quangvd917/ab125-kline/hardware/kline-l9637d/bom.csv

Ref | Value | Footprint | Qty
C1 | 100uF 35V | Capacitor_THT:CP_Radial_D6.3mm_P2.50mm | 1
C2,C4,C5 | 100nF | Capacitor_SMD:C_1206_3216Metric_Pad1.33x1.80mm_HandSolder | 3
C3 | 470uF 16V | Capacitor_SMD:CP_Elec_8x10 | 1
D1 | SS34 | Diode_SMD:D_SMA | 1
D2 | 1N4148W | Diode_SMD:D_SOD-123 | 1
D3 | SMBJ24A | Diode_SMD:D_SMB | 1
D4 | SMBJ18A | Diode_SMD:D_SMB | 1
H1-H4 | M3 | MountingHole:MountingHole_3.2mm_M3 | 4
J1 | DLC (+12V, K, GND) | Connector_JST:JST_XH_S3B-XH-A_1x03_P2.50mm_Horizontal | 1
J2 | ESP32 (5V, GND, TX, 3V3, RX) | Connector_JST:JST_XH_S5B-XH-A_1x05_P2.50mm_Horizontal | 1
J3 | MP1584 IN+ | Connector_PinHeader_2.54mm:PinHeader_1x02_P2.54mm_Vertical | 1
J4 | MP1584 OUT+ | Connector_PinHeader_2.54mm:PinHeader_1x02_P2.54mm_Vertical | 1
J5 | MP1584 IN- | Connector_PinHeader_2.54mm:PinHeader_1x02_P2.54mm_Vertical | 1
J6 | MP1584 OUT- | Connector_PinHeader_2.54mm:PinHeader_1x02_P2.54mm_Vertical | 1
JP1 | LI -> VS (bridge 2-3) | Jumper:SolderJumper-3_P1.3mm_Open_RoundedPad1.0x1.5mm | 1
L1 | 22uH 1A | Inductor_SMD:L_Changjiang_FXL0630 | 1
R1 | 1k 1/4W | Resistor_SMD:R_1206_3216Metric_Pad1.30x1.75mm_HandSolder | 1
U1 | L9637D | Package_SO:SOIC-8_3.9x4.9mm_P1.27mm | 1
