quangvd917/ab125-kline/hardware/kline-l9637d/kline_l9637d_schematic.pdf

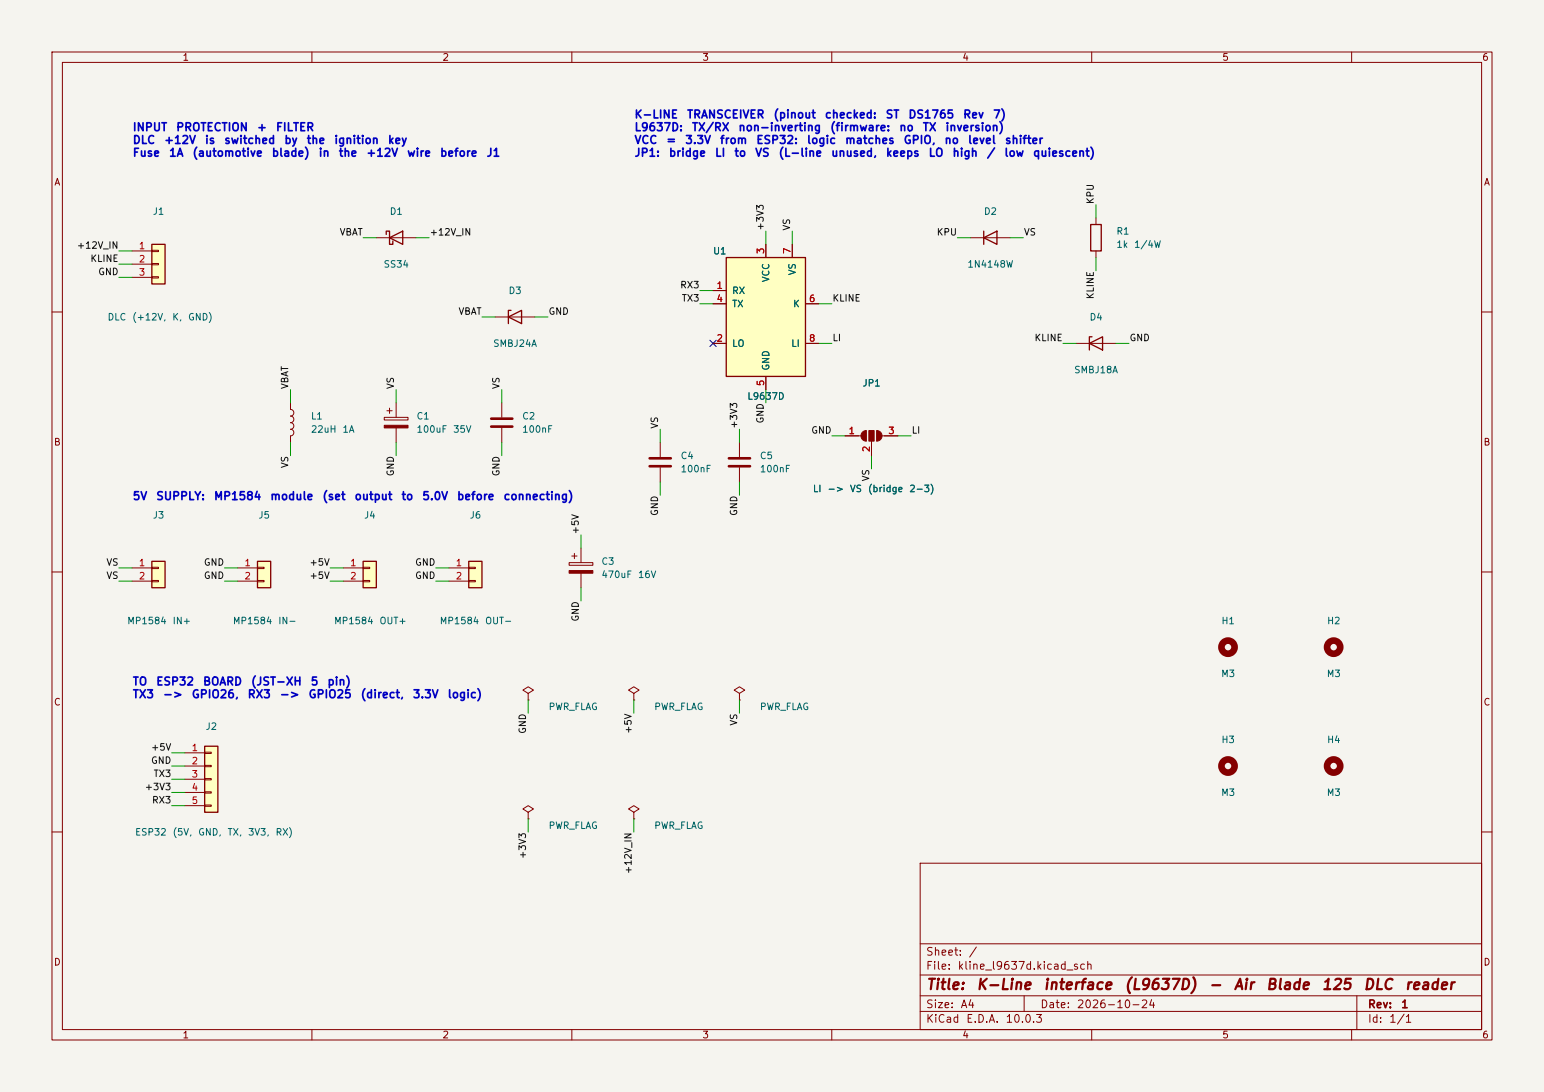
[picture p8: page 1]

INPUT PROTECTION + FILTER
DLC +12V is switched by the ignition key
Fuse 1A (automotive blade) in the +12V wire before J1

L9637D: TX/RX non-inverting (firmware: no TX inversion)
VCC = 3.3V from ESP32: logic matches GPIO, no level shifter
JP1: bridge LI to VS (L-line unused, keeps LO high / low quiescent)

5V SUPPLY: MP1584 module (set output to 5.0V before connecting)

TO ESP32 BOARD (JST-XH 5 pin)
TX3 -> GPIO26, RX3 -> GPIO25 (direct, 3.3V logic)

Sheet: /
File: kline_l9637d.kicad_sch
Title: K-Line interface (L9637D) - Air Blade 125 DLC reader

Size: A4 | Rev: 1
KiCad E.D.A. 10.0.3 | Id: 1/1
