quangvd917/ab125-kline/hardware/kline-l9637d/kline_l9637d.kicad_pcb

## KiCad design hardware/kline-l9637d/kline_l9637d.kicad_pcb (2026-10-25)

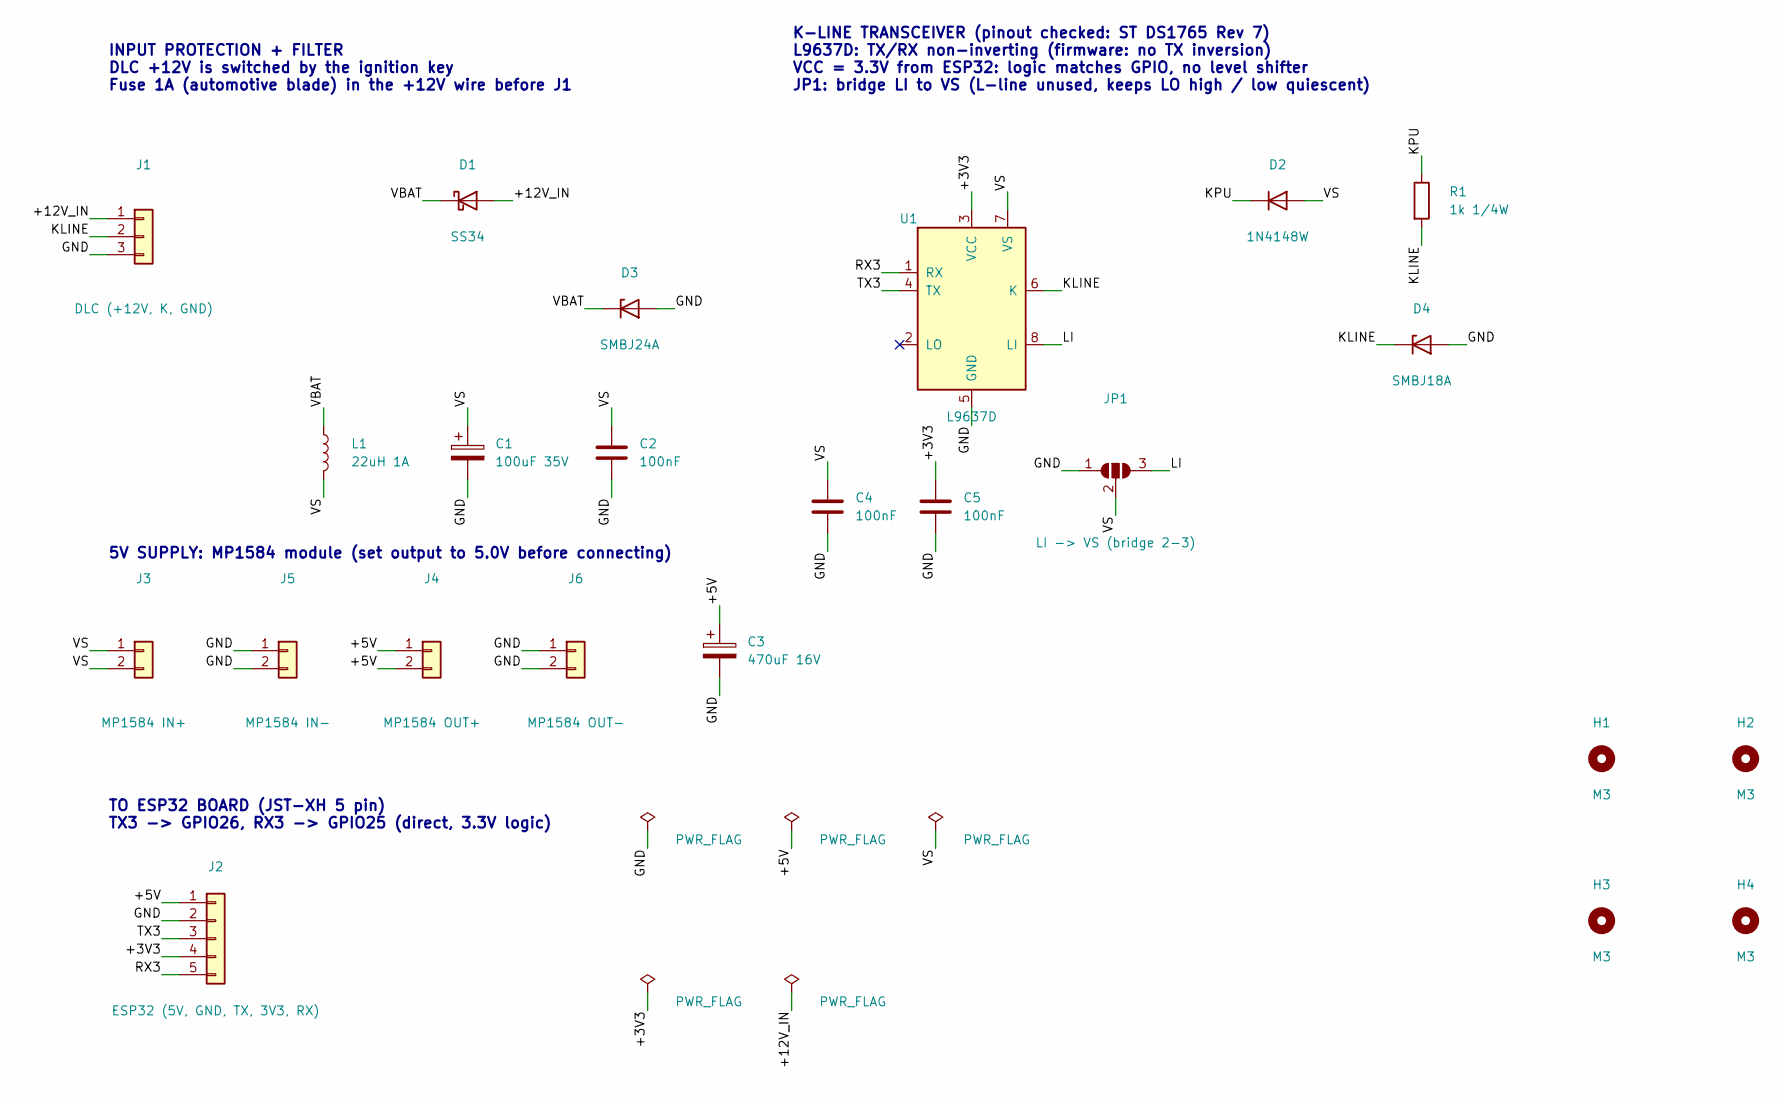
[picture p9: schematic kline_l9637d.kicad_sch, K-Line interface (L9637D) - Air Blade 125 DLC reader]

Parts:
C1: 100uF 35V; CP_Radial_D6.3mm_P2.50mm
C2, C4, C5: 100nF; C_1206_3216Metric_Pad1.33x1.80mm_HandSolder
C3: 470uF 16V; CP_Elec_8x10
D1: SS34; D_SMA
D2: 1N4148W; D_SOD-123
D3: SMBJ24A; D_SMB
D4: SMBJ18A; D_SMB
H1, H2, H3, H4: M3; MountingHole_3.2mm_M3
J1: DLC (+12V, K, GND); JST_XH_S3B-XH-A_1x03_P2.50mm_Horizontal
J2: ESP32 (5V, GND, TX, 3V3, RX); JST_XH_S5B-XH-A_1x05_P2.50mm_Horizontal
J3: MP1584 IN+; PinHeader_1x02_P2.54mm_Vertical
J4: MP1584 OUT+; PinHeader_1x02_P2.54mm_Vertical
J5: MP1584 IN-; PinHeader_1x02_P2.54mm_Vertical
J6: MP1584 OUT-; PinHeader_1x02_P2.54mm_Vertical
JP1: LI -> VS (bridge 2-3); SolderJumper-3_P1.3mm_Open_RoundedPad1.0x1.5mm
L1: 22uH 1A; L_Changjiang_FXL0630
R1: 1k 1/4W; R_1206_3216Metric_Pad1.30x1.75mm_HandSolder
U1: L9637D; SOIC-8_3.9x4.9mm_P1.27mm

Connections:
/+3V3: C5.1, J2.4, U1.3 (VCC)
/+5V: C3.1, J2.1, J4.1, J4.2
/+12V_IN: D1.2 (A), J1.1
/GND: C1.2, C2.2, C3.2, C4.2, C5.2, D3.2 (A), D4.2 (A), J1.3, J2.2, J5.1, J5.2, J6.1, J6.2, JP1.1 (A), U1.5 (GND)
/KLINE: D4.1 (K), J1.2, R1.2, U1.6 (K)
/KPU: D2.1 (K), R1.1
/LI: JP1.3 (B), U1.8 (LI)
/RX3: J2.5, U1.1 (RX)
/TX3: J2.3, U1.4 (TX)
/VBAT: D1.1 (K), D3.1 (K), L1.1
/VS: C1.1, C2.1, C4.1, D2.2 (A), J3.1, J3.2, JP1.2 (C), L1.2, U1.7 (VS)

Notes on the sheet:
K-LINE TRANSCEIVER (pinout checked: ST DS1765 Rev 7) L9637D: TX/RX non-inverting (firmware: no TX inversion) VCC = 3.3V from ESP32: logic matches GPIO, no level shifter JP1: bridge LI to VS (L-line unused, keeps LO high / low quiescent)
5V SUPPLY: MP1584 module (set output to 5.0V before connecting)
INPUT PROTECTION + FILTER DLC +12V is switched by the ignition key Fuse 1A (automotive blade) in the +12V wire before J1
TO ESP32 BOARD (JST-XH 5 pin) TX3 -> GPIO26, RX3 -> GPIO25 (direct, 3.3V logic)

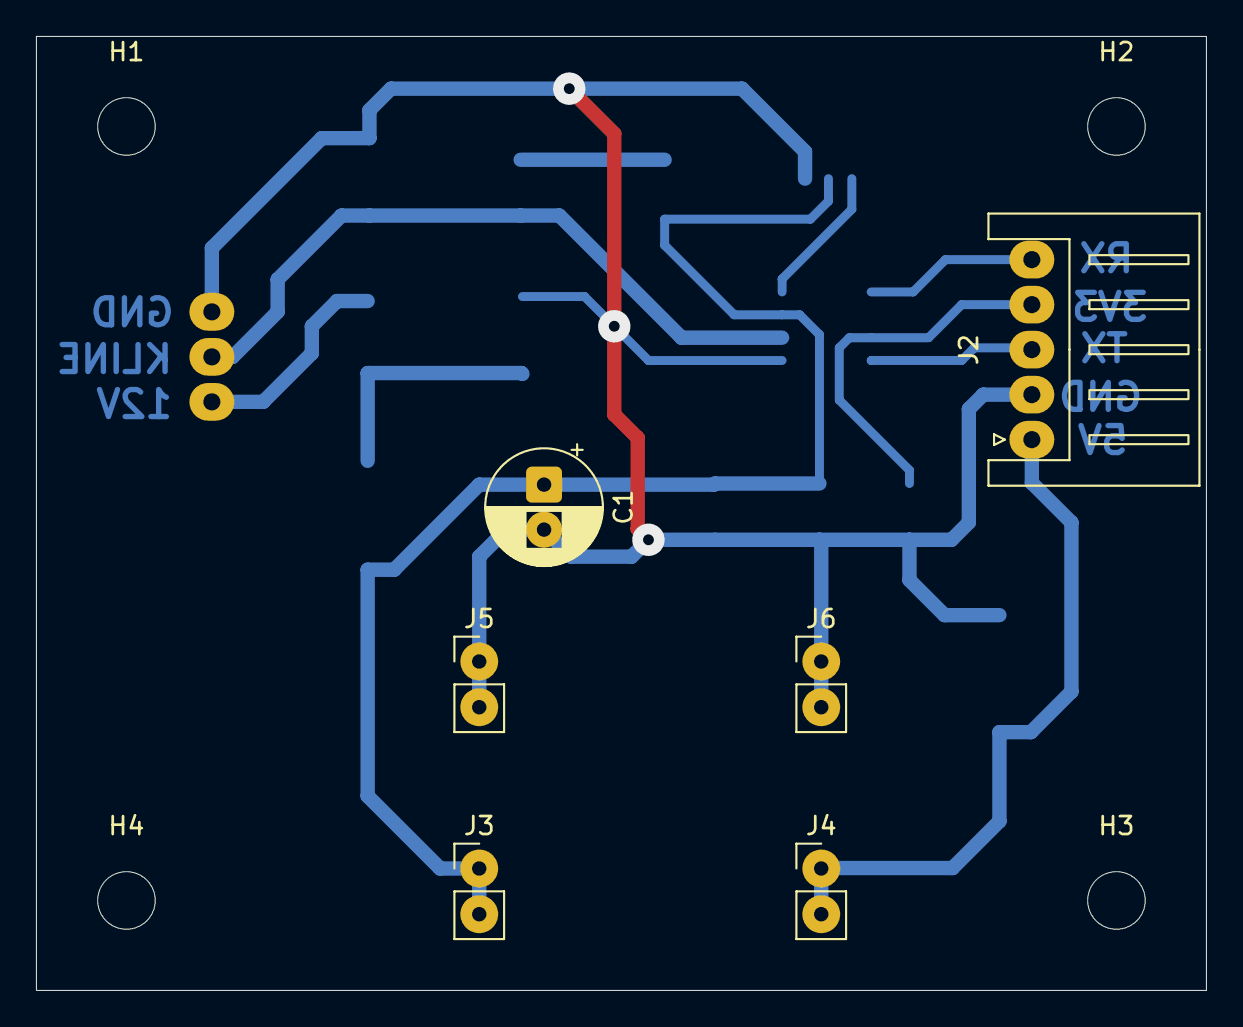
[picture p10: board kline_l9637d.kicad_pcb from above]

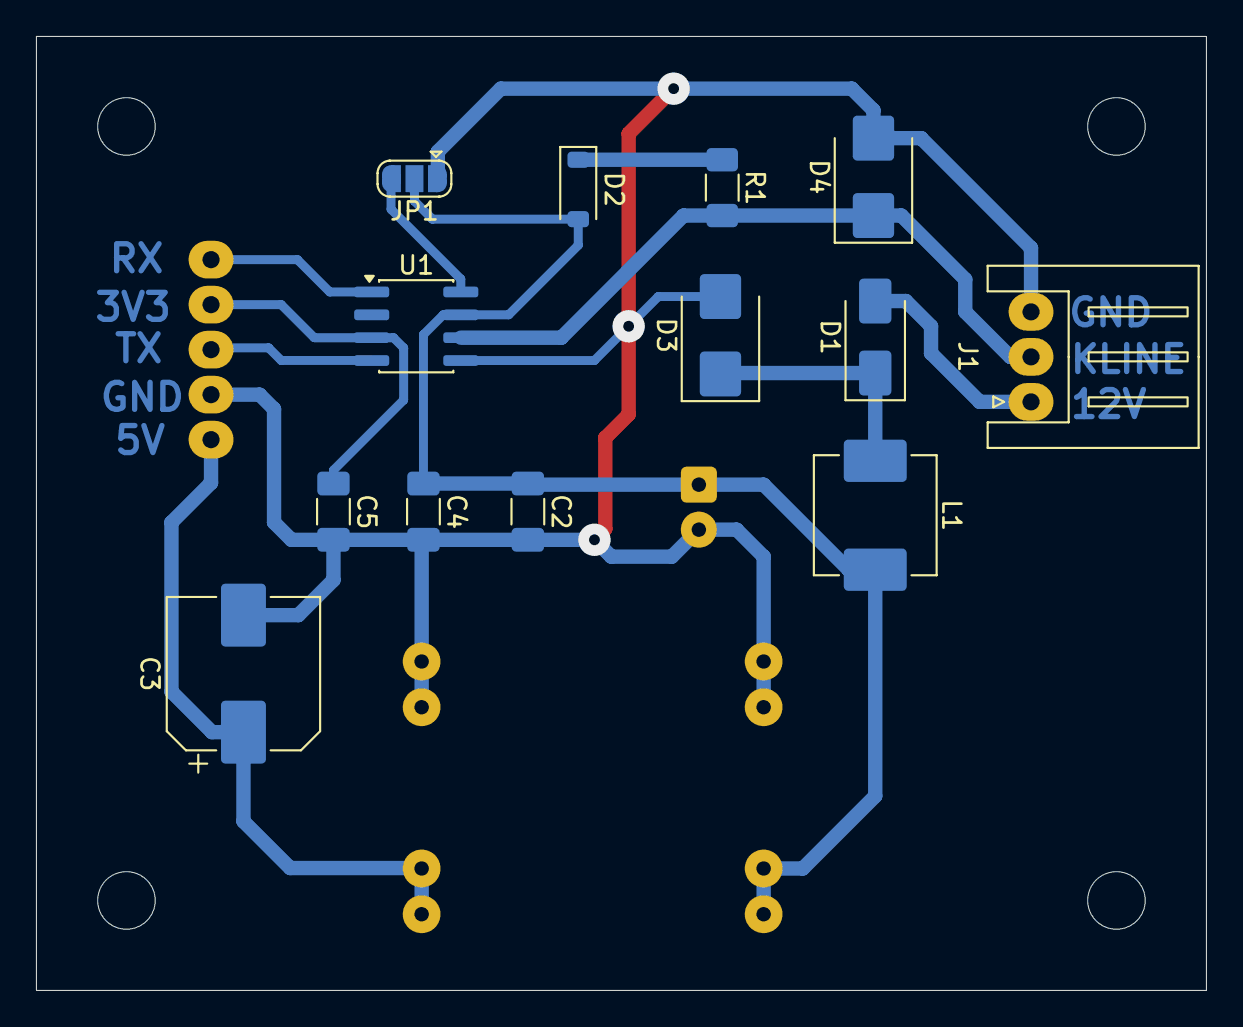
[picture p11: board kline_l9637d.kicad_pcb from below]

Board: 2 copper layers, 65.0 x 53.0 mm, 23 parts (13 on the bottom side), 11 nets.
