quangvd917/ab125-kline/(commit log)

2026-10-25 Initial commit: Honda Air Blade 125 K-Line reader
    - firmware/kline-reader: ESP32-C3 SuperMini + L9637D (also ESP32 + 2N2222),
    reads ECU table 0x17, serves a phone dashboard over WiFi, broadcasts ESP-NOW
    - firmware/dashboard-cyd: 2.8" CYD dashboard receiving ESP-NOW packets
    - firmware/common: shared DashPacket definition
    - hardware/kline-l9637d: KiCad schematic, single-sided PCB, BOM, PDF
    - docs: protocol notes, assembly and test guide, v1 discrete circuit, sample logs
    [bom.csv, kline_l9637d.kicad_pcb, kline_l9637d.kicad_sch]
2026-10-29 Read PGM-FI fault codes and show them on the web dashboard
    - Firmware reads current (0x74) and stored (0x73) fault tables, pages 1-11,
    once per connection and every 30 s, one page per polling cycle
    - GET /dtc returns the codes plus raw pages; read only, no clear command
    - Web UI: fault summary chip and a fault code page with Vietnamese
    descriptions, FI blink counts and a labelled sample-data demo mode
    - Verified on an Air Blade 125 (2023) with no faults: the ECU answers all
    22 pages with 3 empty code slots each
2026-10-29 Add clearing of fault codes from the web dashboard
    - POST /dtc/clear sends "72 05 60 03" (HondaECU command) only with the
    key on, engine stopped and the ECU answering; stale requests expire
    - Air Blade 2023 ECU replies "02 05 60 01 98" and clears the codes, so
    00 and 01 both count as accepted; the result is confirmed by re-reading
    tables 0x74/0x73 right after
    - Web UI: "Xóa lỗi" button with confirmation, disabled while the engine runs
    - Docs: real 8-1 fault test, MIL stays on until cleared, SCS clear procedure
    - ENABLE_DTC_CLEAR=0 builds a read-only firmware
    Tested on the bike with the first version (clear worked but was reported as
    rejected); the confirm-by-re-read logic is built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
